Samy109/Ender-3-3DTruder/CAD/3DTruder_schematic.pdf

# System overview

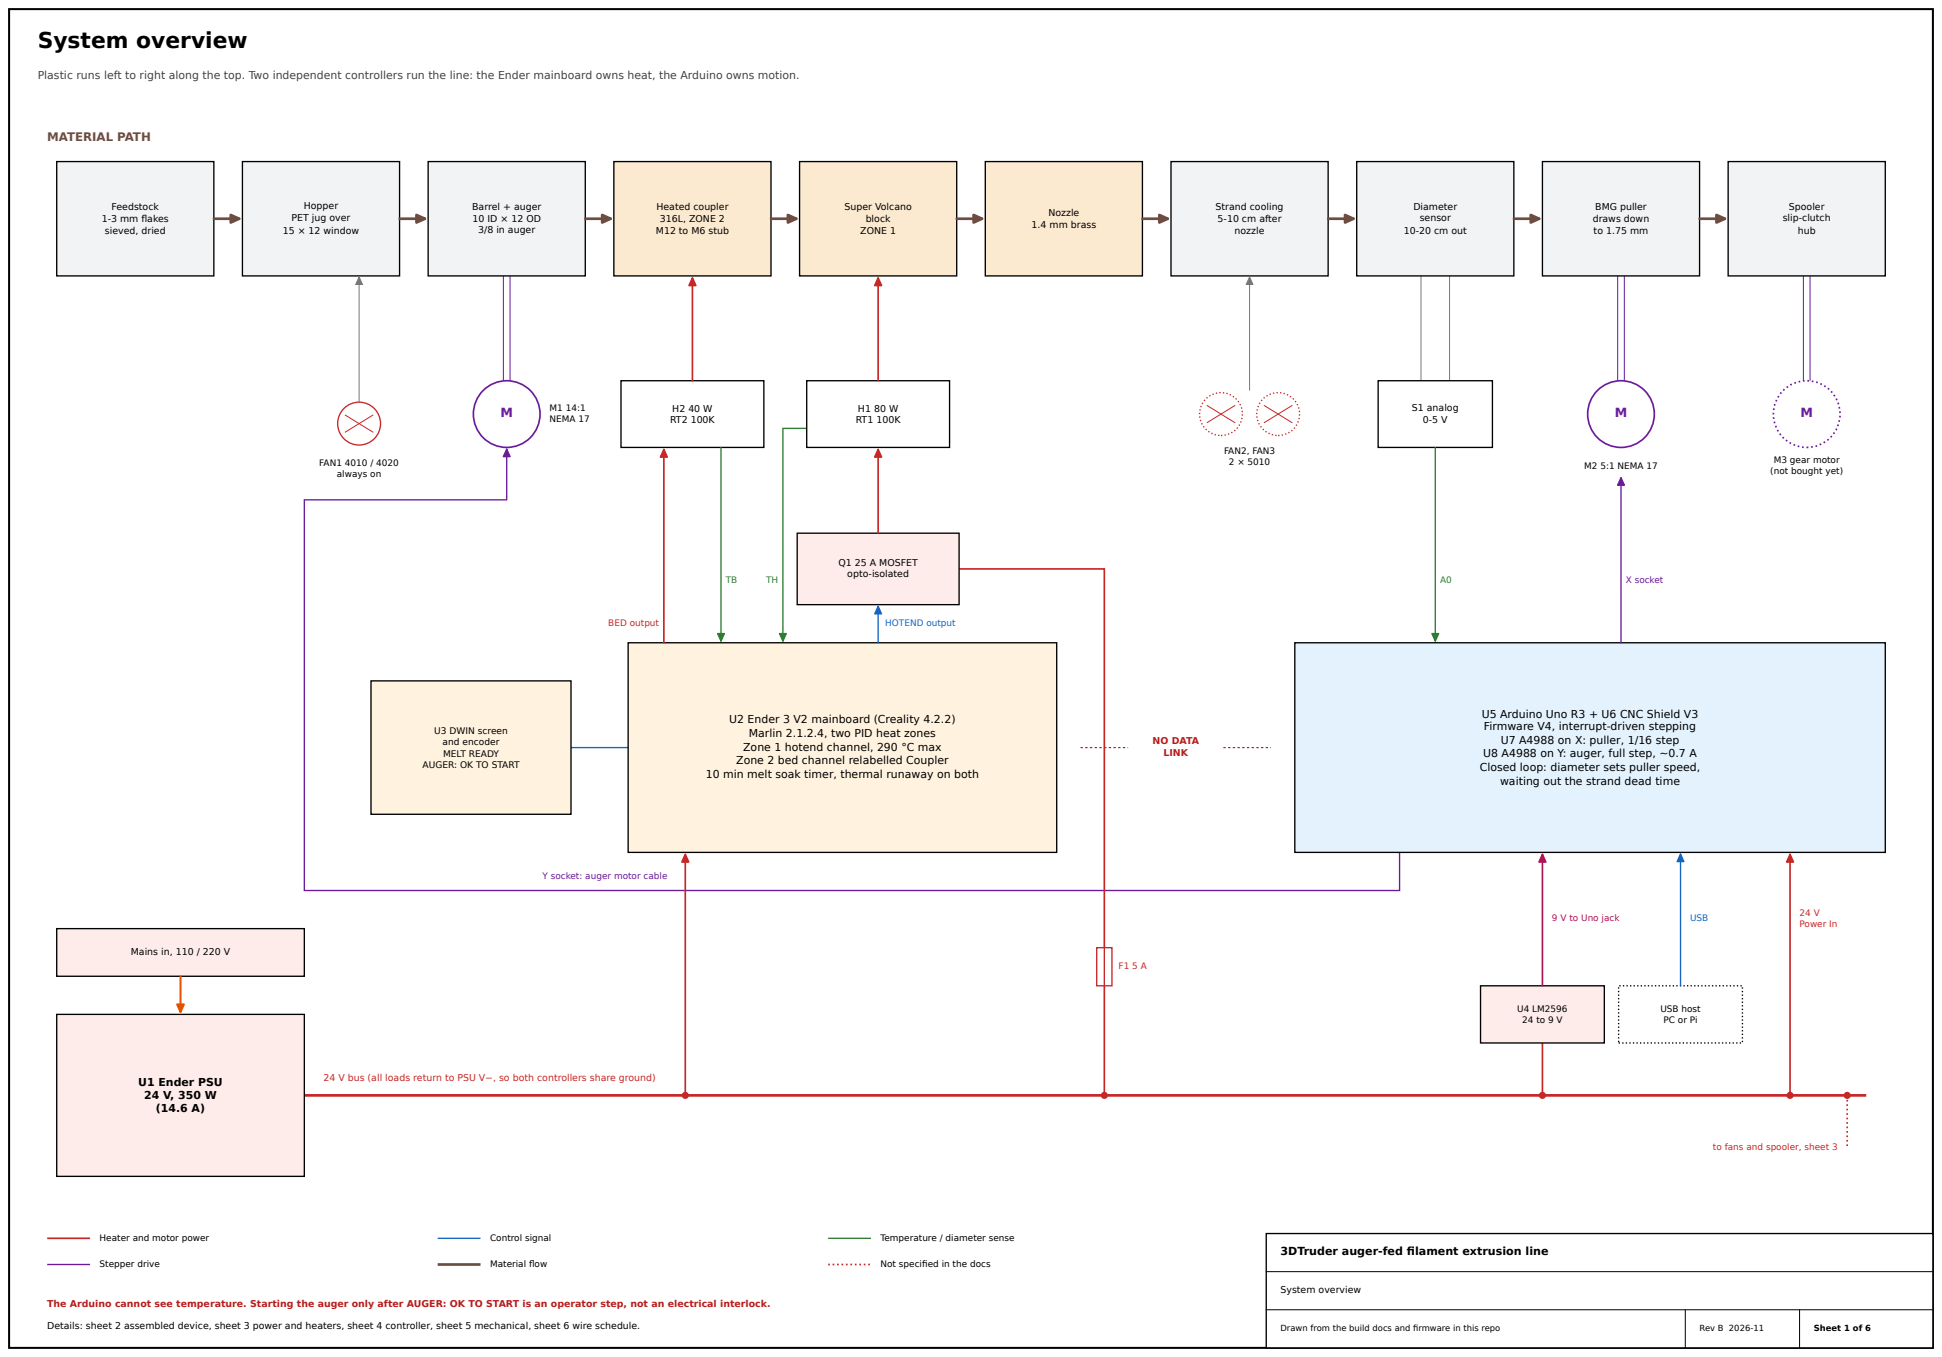
[picture p1: page 1]

Plastic runs left to right along the top. Two independent controllers run the line: the Ender mainboard owns heat, the Arduino owns motion.

U2 Ender 3 V2 mainboard (Creality 4.2.2)
Marlin 2.1.2.4, two PID heat zones
Zone 1 hotend channel, 290 °C max
Zone 2 bed channel relabelled Coupler
10 min melt soak timer, thermal runaway on both

U5 Arduino Uno R3 + U6 CNC Shield V3
Firmware V4, interrupt-driven stepping
U7 A4988 on X: puller, 1/16 step
U8 A4988 on Y: auger, full step, ~0.7 A
Closed loop: diameter sets puller speed,
waiting out the strand dead time

U3 DWIN screen
and encoder
MELT READY
AUGER: OK TO START

Y socket: auger motor cable

24 V bus (all loads return to PSU V−, so both controllers share ground)

to fans and spooler, sheet 3

3DTruder auger-fed filament extrusion line

The Arduino cannot see temperature. Starting the auger only after AUGER: OK TO START is an operator step, not an electrical interlock.

Details: sheet 2 assembled device, sheet 3 power and heaters, sheet 4 controller, sheet 5 mechanical, sheet 6 wire schedule.

# Fully assembled device

Every part in its built position at one common scale (about 1:2.25 at A3), with the electronics and cable runs. Heights and lengths of bought parts are typical values.

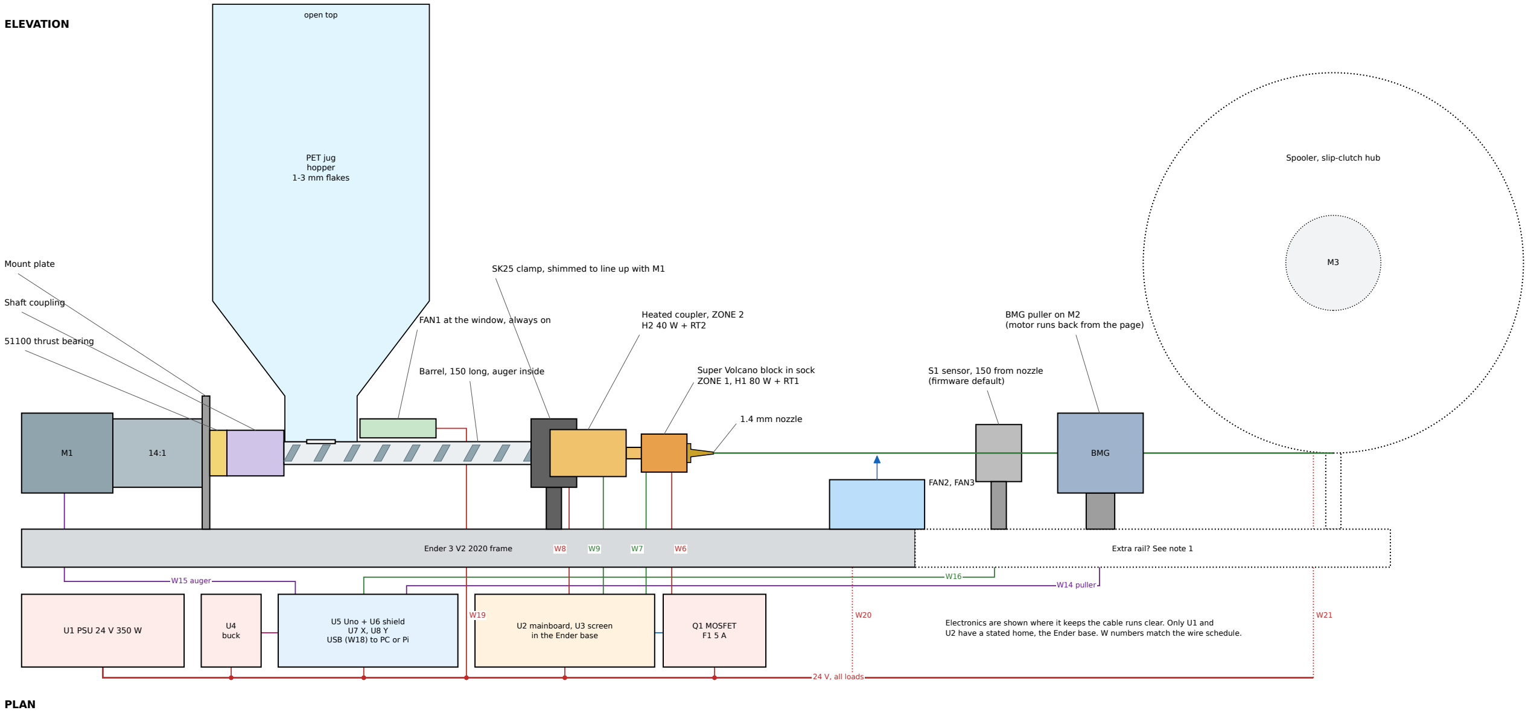
[picture p2: figure]
ELEVATION; PLAN; Ender 3 V2 2020 frame; Extra rail? See note 1; PET jug hopper 1-3 mm flakes; open top; U1 PSU 24 V 350 W; buck; U5 Uno + U6 shield U7 X, U8 Y USB (W18) to PC or Pi; U2 mainboard, U3 screen in the Ender base; Q1 MOSFET F1 5 A; Spooler, slip-clutch hub; BMG; 24 V, all loads; W15 auger; W14 puller; Mount plate; Shaft coupling; 51100 thrust bearing; FAN1 at the window, always on; Barrel, 150 long, auger inside; SK25 clamp, shimmed to line up with M1; Heated coupler, ZONE 2 H2 40 W + RT2; Super Volcano block in sock ZONE 1, H1 80 W + RT1; 1.4 mm nozzle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

Electronics are shown where it keeps the cable runs clear. Only U1 and
U2 have a stated home, the Ender base. W numbers match the wire schedule.

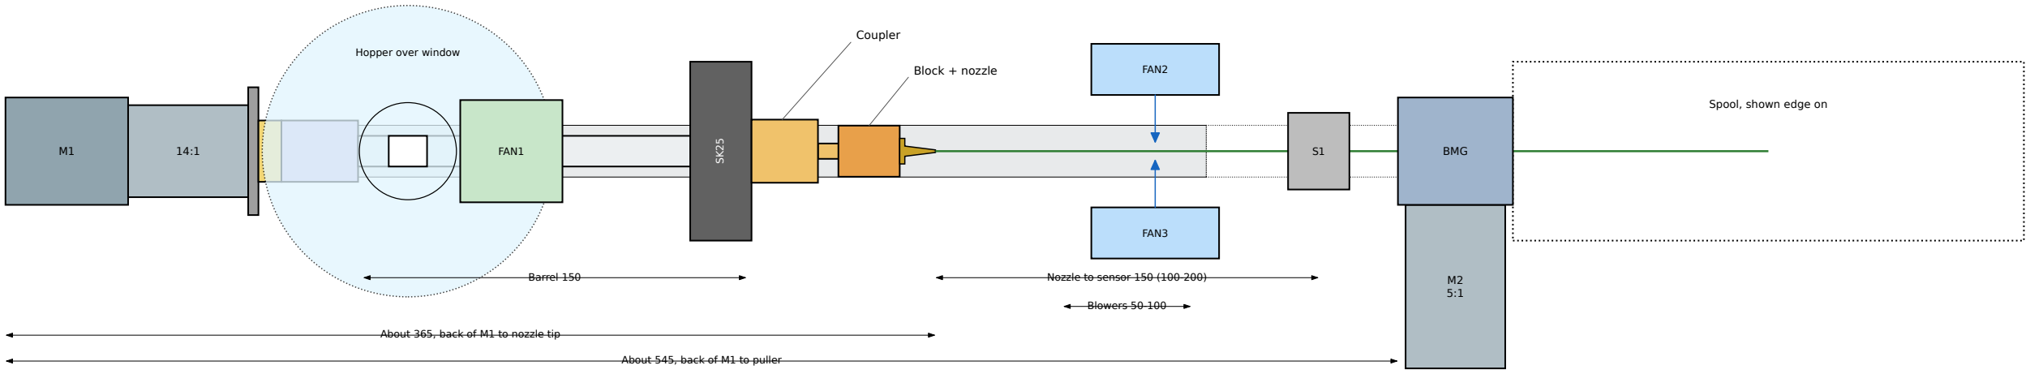
[picture p3: figure]
FAN2; FAN3; FAN1; Hopper over window; Spool, shown edge on; BMG; Barrel 150; Nozzle to sensor 150 (100-200); Blowers 50-100; About 365, back of M1 to nozzle tip; About 545, back of M1 to puller; Coupler; Block + nozzle

1. The docs say the line bolts to the 2020 frame but not to which rail. Back of M1 to puller is about 545 mm and the Ender's footprint is roughly 470 mm, so check the fit. The puller and spooler may need an extra rail or their own stand. Dotted frame is that open question.
2. M1, M2, FAN, BMG, SK25 and spool sizes are typical, not from the repo. Coupler, barrel, thrust bearing and spacings are from the docs. Ender gantry, motors and belts are not drawn.

3DTruder auger-fed filament extrusion line

Fully assembled device

Drawn from the build docs and firmware in this repo | Rev B 2026-11 | Sheet 2 of 6

# Power distribution and heaters

Ladder layout: the 24 V bus runs along the top, the 0 V bus along the bottom, and every load is a rung between them.

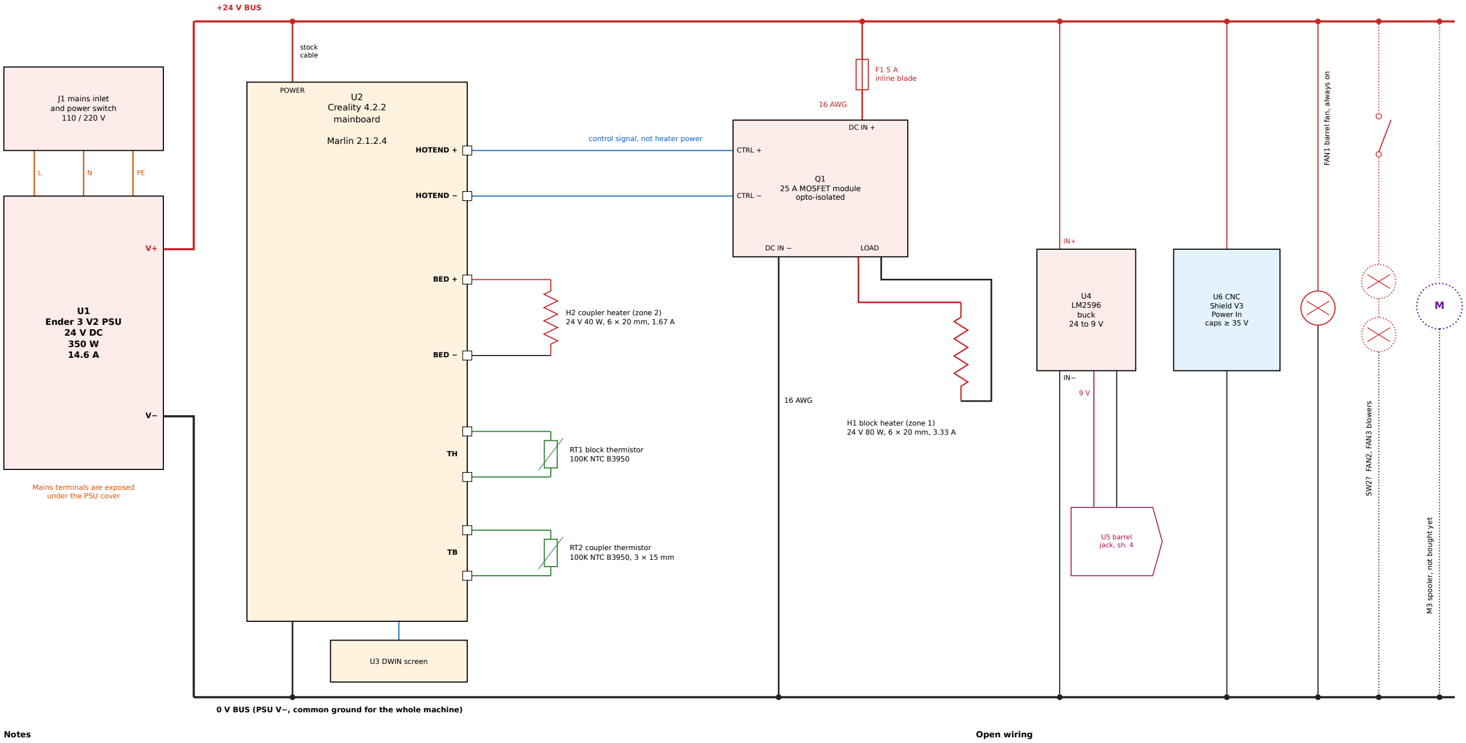
[picture p4: figure]
H2 coupler heater (zone 2) 24 V 40 W, 6 × 20 mm, 1.67 A; RT1 block thermistor 100K NTC B3950; RT2 coupler thermistor 100K NTC B3950, 3 × 15 mm; H1 block heater (zone 1) 24 V 80 W, 6 × 20 mm, 3.33 A; FAN1 barrel fan, always on; SW2? FAN2, FAN3 blowers; M3 spooler, not bought yet; Notes; Open wiring; J1 mains inlet and power switch 110 / 220 V; U1 Ender 3 V2 PSU 24 V DC 350 W 14.6 A; U2 Creality 4.2.2 mainboard; Marlin 2.1.2.4; U3 DWIN screen; Q1 25 A MOSFET module opto-isolated; U4 LM2596 buck 24 to 9 V; U5 barrel jack, sh. 4; U6 CNC Shield V3 Power In caps ≥ 35 V; POWER; HOTEND +; HOTEND −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

1. Unplug from the wall before touching PSU or mainboard wiring.
2. H1 must go through Q1. Its 3.33 A is more than the mainboard MOSFET should carry continuously. H2's 1.67 A is within the bed MOSFET's rating.
3. Connect both thermistors before heating. An unplugged one halts that zone with MINTEMP (5 °C). Limits: nozzle MAXTEMP 305 °C (290 °C settable), coupler 290 °C (280 °C settable).
1. Dotted rungs: the docs do not say how FAN2, FAN3 or M3 are powered. The bus feed and SW2 are the obvious way to do it, not a documented design. A 12 V spooler needs its own buck.
Mains | +24 V | 0 V | Control signal
Thermistor | 9 V | Not specified in the docs

3DTruder auger-fed filament extrusion line

Power distribution and heaters

Drawn from the build docs and firmware in this repo | Rev B 2026-11 | Sheet 3 of 6

### 0 V BUS (PSU V−, common ground for the whole machine)

# Motion controller: Arduino Uno and CNC Shield V3

U6 plugs straight onto U5, so the links between them are header pins, not loose wires. Only the connections at the far left and right are wired by hand.

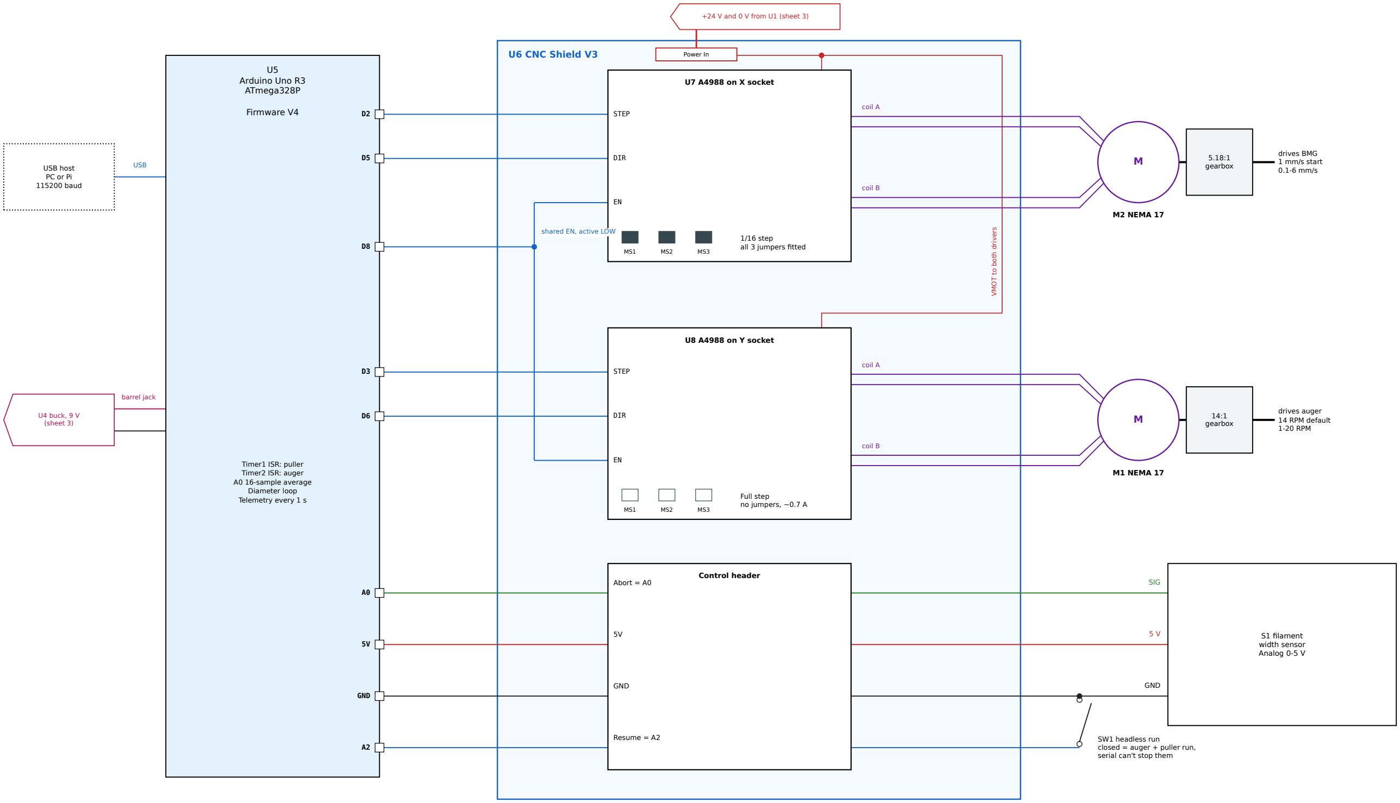
[picture p5: figure]
USB; barrel jack; M2 NEMA 17; drives BMG 1 mm/s start 0.1-6 mm/s; M1 NEMA 17; drives auger 14 RPM default 1-20 RPM; SW1 headless run closed = auger + puller run, serial can't stop them; U5 Arduino Uno R3 ATmega328P; Firmware V4; U6 CNC Shield V3; USB host PC or Pi 115200 baud; U4 buck, 9 V (sheet 3); +24 V and 0 V from U1 (sheet 3); M 5.18:1 gearbox; M 14:1 gearbox; S1 filament width sensor Analog 0-5 V; Timer1 ISR: puller Timer2 ISR: auger A0 16-sample average Diameter loop Telemetry every 1 s; GND; U8 A4988 on Y socket; STEP; DIR; Full step no jumpers, ~0.7 A; Power In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

1. Check the shield's capacitors before applying 24 V: 35 V or 50 V only. Budget shields often ship with 16 V or 25 V parts. Otherwise replace them or run the shield from 12 V.
2. Set U4's output to 9 V with a multimeter before connecting it to the Uno. These modules are adjustable and can arrive set well above 9 V.
3. Auger current is the torque limit: a jam must make M1 skip, not build pressure against the thin barrel thread. Don't raise it to push through a jam.
Step / dir / enable | Stepper coils | Sensor signal | Supply
U7 A4988 on X socket STEP DIR EN | 1/16 step all 3 jumpers fitted

3DTruder auger-fed filament extrusion line

Motion controller: Arduino Uno and CNC Shield V3

Drawn from the build docs and firmware in this repo | Rev B 2026-11 | Sheet 4 of 6

# Mechanical layout and melt path

View A is a side view of the whole line, not to scale. View B is a section through the melt path at 2.5:1, with coupler and barrel to scale.

VIEW A Full line, side view (not to scale)

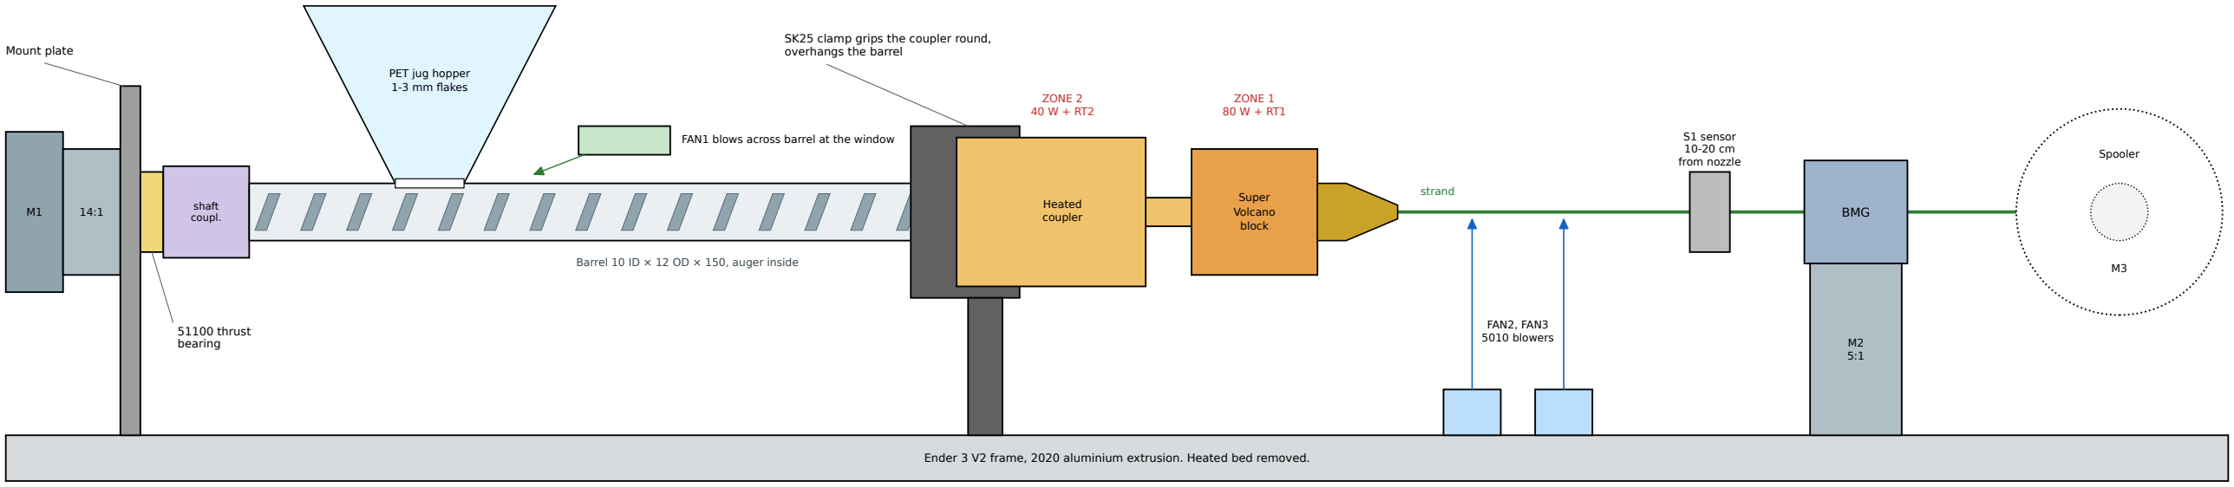
[picture p6: figure]
10-20 cm from nozzle; shaft; coupl.; PET jug hopper 1-3 mm flakes; BMG; Heated coupler; Super Volcano block; Spooler; ZONE 2 40 W + RT2; ZONE 1 80 W + RT1; strand; FAN2, FAN3 5010 blowers; Mount plate; 51100 thrust bearing; SK25 clamp grips the coupler round, overhangs the barrel

Barrel 10 ID × 12 OD × 150, auger inside

FAN1 blows across barrel at the window | S1 sensor

Load paths: melt pressure on the auger goes coupling → 51100 → plate → frame, not through the gearbox. Pressure on the coupler goes SK25 → frame, not through the thin barrel thread.

VIEW B Melt path section, 2.5:1

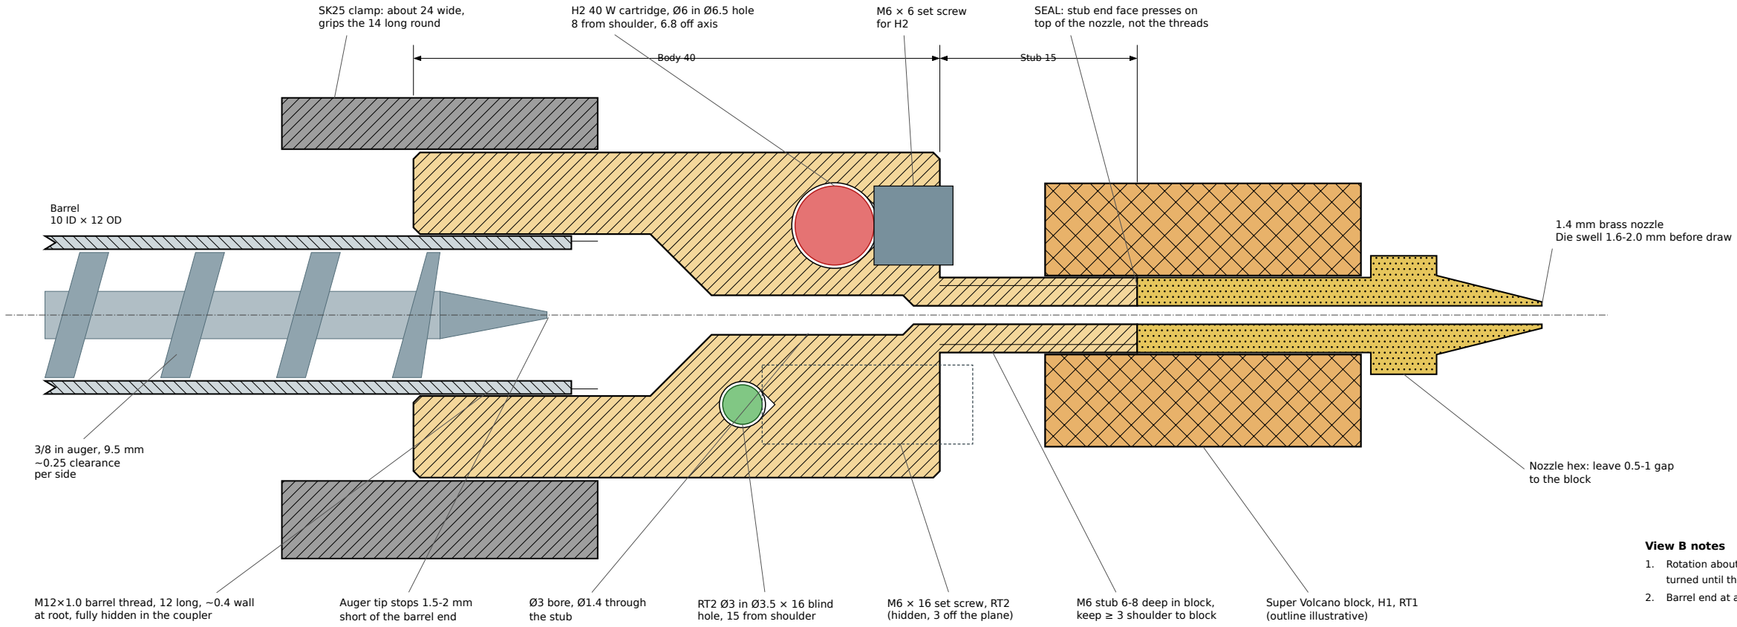
[picture p7: figure]
Barrel 10 ID × 12 OD; View B notes; Body 40; Stub 15; SK25 clamp: about 24 wide, grips the 14 long round; H2 40 W cartridge, Ø6 in Ø6.5 hole 8 from shoulder, 6.8 off axis; M6 × 6 set screw for H2; SEAL: stub end face presses on top of the nozzle, not the threads; 3/8 in auger, 9.5 mm ~0.25 clearance per side; at root, fully hidden in the coupler; Auger tip stops 1.5-2 mm short of the barrel end; Ø3 bore, Ø1.4 through the stub; RT2 Ø3 in Ø3.5 × 16 blind hole, 15 from shoulder; M6 × 16 set screw, RT2 (hidden, 3 off the plane); M6 stub 6-8 deep in block, keep ≥ 3 shoulder to block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

1. Rotation about the axis is set by the barrel thread, then the whole assembly is turned until the hopper window faces up. Drawn with H2 on top for clarity.
2. Barrel end at about z 28, assuming the 12 mm thread is fully run in.

Ender 3 V2 frame, 2020 aluminium extrusion. Heated bed removed.

3DTruder auger-fed filament extrusion line

Mechanical layout and melt path

Drawn from the build docs and firmware in this repo | Rev B 2026-11 | Sheet 5 of 6

M12×1.0 barrel thread, 12 long, ~0.4 wall

# Wire schedule and settings

Every connection and every value you need at the bench. Source for each is the manual, the sketch or Configuration.h.

Wire schedule

Wire | From | To | Carries | Cable / note
W1 | J1 mains inlet | U1 PSU L, N, PE | 110 / 220 V AC | Stock. Unplug before touching
W2 | U1 V+, V− | U2 POWER | 24 V | Stock cable
W3 | U1 V+ | F1, then Q1 DC IN + | 24 V, 3.33 A | 16 AWG red, 5 A fuse on +
W4 | U1 V− | Q1 DC IN − | 0 V | 16 AWG black
W5 | U2 HOTEND +, − | Q1 CONTROL +, − | PWM control | Signal cable, mind polarity
W6 | Q1 LOAD | H1 80 W block heater | 24 V, 3.33 A | Heater leads
W7 | RT1 block thermistor | U2 TH | Temp sense | Marlin sensor type 1
W8 | H2 40 W coupler heater | U2 BED screw terminals | 24 V, 1.67 A | Route away from nozzle
W9 | RT2 coupler thermistor | U2 TB | Temp sense | Marlin sensor type 1
W10 | U2 | U3 DWIN screen | Serial UI | Stock cable
W11 | U1 V+, V− | U6 Power In | 24 V motor power | Check caps first
W12 | U1 V+, V− | U4 IN | 24 V
W13 | U4 OUT | U5 barrel jack | 9 V | Set 9 V before connecting
W14 | U6 X motor header | M2 puller, 5:1 | Stepper coils | Swap a coil pair to reverse
W15 | U6 Y motor header | M1 auger, 14:1 | Stepper coils | Swap a coil pair to reverse
W16 | U6 Abort (A0), 5V, GND | S1 SIG, VCC, GND | 0-5 V analog | Not a digital runout switch
W17 | U6 Resume (A2), GND | SW1 run switch | Closed = run | Optional, headless only
W18 | U5 USB | PC or Pi | 115200 baud | Commands and telemetry
W19 | U1 V+, V− | FAN1 4010 / 4020 | 24 V | Always on, no switch
W20 | Not specified | FAN2, FAN3 5010 | 24 V assumed | OPEN: docs give no supply or switch
W21 | Not specified | M3 spooler | 24 V or 12 V | OPEN: not bought. 12 V needs a buck

Drivers

Stepper driver | Socket / jumpers | Step mode | Current
U7 puller (M2) | X, 3 jumpers fitted | 1/16 | Motor's comfortable running current
U8 auger (M1) | Y, no jumpers | Full, 2800 steps/rev | ~0.7 A, torque limit

Vref = 8 × Rs × I. At 0.7 A: R100 sense resistor 0.56 V, R050 sense resistor 0.28 V.

Presets

Preset | Nozzle | Coupler
PLA | 215 °C | 205 °C
PETG | 240 °C | 230 °C
PET #1 | 270 °C | 260 °C

Arduino pin map

Arduino pin | Shield label | Function
D2 (PD2) / D5 | X STEP / DIR | Puller, Timer1 ISR
D3 (PD3) / D6 | Y STEP / DIR | Auger, Timer2 ISR
D8 | EN | Active LOW, both drivers
A0 | Abort | Diameter sensor
A2 | Resume | Run switch to GND, pull-up

Thermal protection

Marlin setting | Value
Soak timer | 10 min, within 3 °C, resets past 5 °C
MINTEMP both zones | 5 °C
MAXTEMP nozzle / coupler | 305 / 290 °C
Settable max | 290 / 280 °C
Thermal runaway | 60 s, 4 °C, both zones

Calibration

Controller value | Default | Set at commissioning
PULL_STEPS_PER_MM | 2150 | 2150 × 60 / L
SENSOR_DISTANCE_MM | 150 | Measure nozzle to sensor
CAL_ADC_A at 1.50 mm | 300 | Read RAW with gauge pin
CAL_ADC_B at 2.00 mm | 700 | Read RAW with gauge pin
TARGET_DIA / dead band | 1.75 / ±0.02 | Fixed
Correction | Gain 0.5 | Capped ±10 %, min 2 s apart

Serial, 115200 baud, Newline

Serial command | Action
START / STOP, OFF | Auger + puller on / off
PULL ON / OFF | Puller only, for threading
AUG ON / OFF | Auger only, 1.5 s soft start
SPEED <x> | Puller, 0.1-6 mm/s
RPM <x> | Auger, 1-20 RPM
AUTO ON / OFF | Diameter regulation on / frozen
HELP | List commands

Open items at Rev B

1. FAN2, FAN3 supply and switching (W20). The procedure says "Blowers on" but gives no wiring, and the screen menu has no fan item.
2. M3 spooler (W21) is still to buy, so its voltage is not settled.
3. F1 protects only the heater branch. U4, U6, FAN1 and the blower and spooler rungs have no fuse of their own in the docs.
4. The barrel's M12×1.0 thread is listed as still to do in the parts list.

Reference designators

1. U1 PSU, U2 mainboard, U3 screen, U4 buck, U5 Uno, U6 shield, U7 U8 A4988, Q1 MOSFET, F1 fuse, H1 H2 heaters, RT1 RT2 thermistors, M1 auger, M2 puller, M3 spooler, FAN1 barrel fan, FAN2 FAN3 blowers, S1 diameter sensor, SW1 run switch, SW2 blower switch (assumed), J1 mains inlet.

Power and unused hardware

1. Known heater load is 120 W, or 5.0 A of the PSU's 14.6 A. Motors and fans aren't rated in the docs, but that leaves plenty of margin.
2. Ender X, Y, Z and E motor outputs and endstops are not used by this build.

Bring-up order

1. Before any power: check the shield's capacitors are 35 V or 50 V, and set U4 to 9 V on a multimeter with the Uno disconnected.
2. Flash Marlin to U2 and the sketch to U5. Set Vref on U7 and U8 and fit the jumpers.
3. First boot, cold, both thermistors plugged in: the nozzle and COUPLER readouts should both show 20-25 °C.
4. Heat to 250 °C, hold the coupler flats with a 22 mm wrench and tighten the nozzle a further 1/8 turn against the stub.
5. PID tune both zones and save: M303 E0 S220 C8 U1, then M303 E-1 S205 C8 U1, then M500.
6. Heaters off, barrel empty: check both motor directions, calibrate S1 with gauge pins, then puller steps/mm and sensor distance. Re-upload the sketch.
7. Watch one full soak on a preset, through SOAKING: 10:00 to AUGER: OK TO START, before the first run.

3DTruder auger-fed filament extrusion line

Wire schedule and settings

Drawn from the build docs and firmware in this repo | Rev B 2026-11 | Sheet 6 of 6
