Samy109/Ender-3-3DTruder/CAD/shop_order.md

# Print Order: Heated Barrel Coupler

| | |
|---|---|
| **Customer** | Adam Humphries |
| **Part** | Heated barrel coupler, qty 1 |
| **Print file** | `barrel_coupler.step` (all threads modelled and printed) |
| **Drawing** | `barrel_coupler_drawing.pdf` (BC-001 Rev E, generated by `make_drawing.py`) |
| **Process / material** | Metal 3D printing (SLM), 316L stainless steel. Aluminum not acceptable (service temperature 280 °C) |
| **Units** | mm |
| **Tolerance** | ±0.3 on sizes, ±0.5 on holes (standard SLM). No tighter tolerance anywhere, no machining |
| **Finish** | Stress relieved, supports removed, bead blasted |

---

| Feature | As modelled |
|---|---|
| Body | 40 long excluding stub: heater block 21.7 × 24.7 (z 0–26), then Ø24.7 round (z 26–40) |
| Top bore | M12×1.0 internal thread, printed, 14 full thread; hole 18 deep with a 90° cone floor; 0.5 × 45° chamfer |
| Stub | M6×1.0 external thread, printed, full length (15), runs out at the shoulder |
| Through bore | Ø1.4 through the stub and 2 into the body, then a 90° cone up to Ø3.0 through the rest of the body |
| Wrench flats | 21.7 A/F: the two faces of the heater block that the cross holes exit through, 0–26 from the shoulder; 45° corner chamfers into the round |
| Heater hole | Ø6.5 through, perpendicular to the axis and to the flats (exits through both), 6.8 off-center, 8 from the shoulder; 45° teardrop roof |
| Thermistor hole | Ø3.5 × 16 deep from one flat, parallel to the heater hole, 6.8 off-center on the opposite side, 15 from the shoulder; 45° teardrop roof |
| Set screws | M6×1.0 internal threads, printed, from the shoulder face into the heater and thermistor holes |

**Notes**
1. Print axis vertical, top (M12) face on the plate, stub up. The teardrop roofs, the cone floor and the 45° block corners are there so no supports are needed.
2. Every fit already allows for the tolerance. The threads are offset in the model: the M6 stub is 0.3 under size and the M12 and M6 set-screw threads are 0.3 over (a tight internal thread will be chased with a tap). The holes the cartridges slide into are 0.5 over, and the flats and the clamp round are 0.3 under. Print the model as it is; don't correct these sizes back to nominal.
3. Keep the bore, threads and cross holes clear of powder.
4. Minimum wall is 2.0 mm except the M6 stub (1.5 mm under the thread root, the most an M6 allows) and the thread teeth themselves. All threads are M6 or larger and are modelled in the file; no tapping or other machining is needed from you.

**Customer checks on arrival**
- [ ] The M6 stub screws into the Super Volcano block by hand
- [ ] The barrel's M12×1.0 thread screws into the top by hand
- [ ] A 6 mm cartridge slides into the heater hole and a 3 mm thermistor into its hole
- [ ] M6 set screws run in by hand or with a hex key (chase with an M6×1.0 tap if tight; same for the M12 with the M12×1.0 tap)
- [ ] A 22 mm wrench fits the flats
- [ ] Clear sight line through the bore (if the Ø1.4 printed small or holds powder, run a 1.4 mm drill through by hand)
