Samy109/Ender-3-3DTruder/CAD/barrel_coupler.step

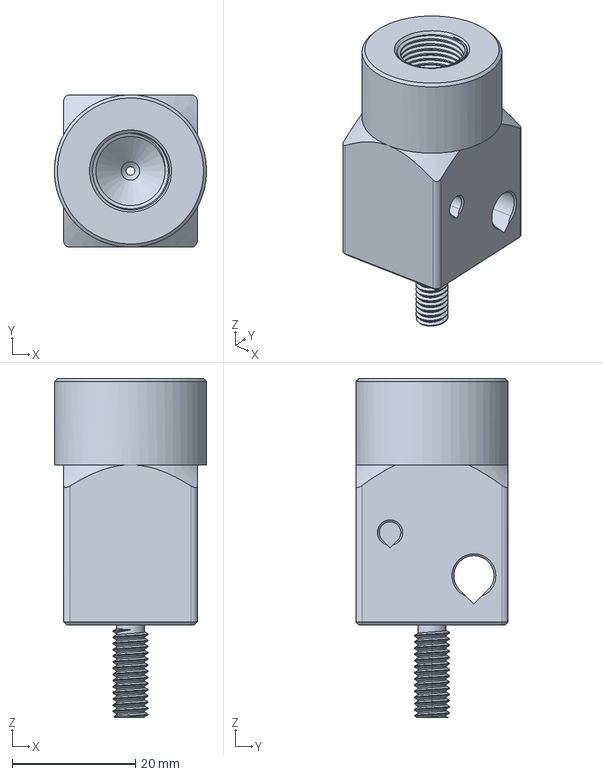
[picture p8: CAD file, 2026-10-26]
CAD/barrel_coupler.step
24.7 x 24.7 x 55.0 mm
