Samy109/Ender-3-3DTruder/(list of files, cad)

Other CAD files:
CAD/barrel_coupler.stl
