Samy109/Ender-3-3DTruder/Ender_3_3DTruder_Master_Manual.html

Build & Operating Manual

3DTRUDER MASTER MANUAL

Auger-Fed Super Volcano Extrusion Line

Turns an Ender 3 V2 into a closed-loop recycling line that extrudes shredded plastic into 1.75 mm filament.

Melt Path

316L Coupler → Super Volcano

Two heat zones: 80 W block + 40 W heated coupler, no heatbreak

Nozzle

1.4 mm Brass Super Volcano

Die swell drawn down to 1.75 mm by the puller

Auger Drive

14:1 NEMA 17 + 51100 Bearing

3/8" auger in a 10 × 12 mm stainless barrel, ~0.7 A torque limit

Control

Arduino V4 + Marlin Soak Timer

Interrupt-driven motors, dead-time-aware diameter loop

Revision: 4.0 (October 2026)

Platform: Ender 3 V2 Conversion

Output: 1.75 mm Recycled Filament

3DTruder Master Manual1. Overview & Safety

# 📌 1. Overview & Safety

## How it works

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

## Safety Warnings

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

## Design notes

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

3DTruder Master Manual2. Bill of Materials

# 🛒 2. Bill of Materials

Full list with specs and links: amazon_parts_list.md. Shop-made parts: CAD/shop_order.md.

## 🔹 Base Unit

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

## 🔹 Melt Zone

- Super Volcano heater block + 1.4 mm Super Volcano brass nozzle + silicone sock
- 80 W 24 V heater cartridge + 100K NTC B3950 thermistor cartridge
- 25 A external MOSFET module + 16 AWG silicone wire + 5 A inline fuse
- Heated barrel coupler (316L stainless, metal 3D printed at ±0.3 mm on sizes and ±0.5 mm on holes, threads printed): 40 mm long: a 21.7 × 24.7 mm heater block (its 21.7 mm faces are the wrench flats) under a Ø24.7 mm round for the clamp. M12×1.0 female top, M6×1.0 male stub (15 mm, full thread), Ø1.4 mm bore through the stub and 2 mm into the body, opening to Ø3 mm above that, flats for a 22 mm wrench, cross holes for a 6 mm heater cartridge and a 3 mm thermistor, M6 set screws. No machining expected; the taps and drill under Tools are only for cleanup if something prints tight. See CAD/shop_order.md and CAD/barrel_coupler.step.
- SK25 shaft support: clamps the coupler's round top section to the frame.
- M6 stainless set screws: one 6 mm (heater) and one 16 mm (thermistor), plus a 3 mm hex key.
- Coupler heat zone: 24 V 40 W 6 × 20 mm cartridge heater + 100K B3950 thermistor cartridge (3 × 15 mm), wired to the mainboard's bed terminals and TB thermistor header.
- PTFE thread tape for the barrel thread.

## 🔹 Auger Feed

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

## 🔹 Hopper & Feedstock

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

## 🔹 Puller & Control

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

## 🔹 Tools

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

3DTruder Master Manual3. Feedstock & Hopper

# 📥 3. Feedstock & Hopper

## 3.1 Sifting (3-Stage Stack)

Stack screens top to bottom: 5 mm → 3 mm → 1 mm → catch pan, and shake well.

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

ⓘ Note

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

## 3.2 Pre-Drying

Moisture boils in the melt zone and causes popping, voids and brittle filament.

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

## 3.3 Bottle Hopper

The barrel is horizontal, so the hopper sits upside-down on top of the window.

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

3DTruder Master Manual4. Phase 1: Auger, Barrel & Melt Zone Assembly

# 🔧 4. Phase 1: Auger, Barrel & Melt Zone Assembly

## 4.1 Modifying the Auger Bit

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

## 4.2 Motor, Thrust Bearing & Shaft Coupling

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

## 4.3 Barrel Prep

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

## 4.4 Melt Zone Assembly

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

## 4.5 Heater Wiring

Zone 1, Super Volcano block (80 W), through the external MOSFET:

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

Zone 2, coupler (40 W), straight to the board:

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

! Warning

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

## 4.6 First Boot, First Heat, Hot-Tighten & PID

1. Flash the Ender 3 V2 firmware (see Ender3_Firmware/README.md): firmware_Ender3_V2_RE.bin or _RC.bin to match the chip on your board. If the board has been flashed before, rename the file to something new so the bootloader picks it up.
2. First boot, cold: both thermistors plugged in (nozzle on TH, coupler on TB). The nozzle readout and the COUPLER: line should both show room temperature (about 20–25 °C). A reading near or below 0 °C, or an error, means a thermistor isn't connected.
3. Set the hotend to 250 °C and wait a few minutes.
4. Hold the coupler's flats with a 22 mm wrench (on the upper part of the flats, clear of the heater and thermistor leads) and tighten the nozzle a further ⅛ turn against the stub.
5. Run PID autotune on both zones and save, either from the screen (Configuration → Advanced Settings → PID Autotune for the nozzle and the Coupler, then Store Settings) or over USB:

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

The coupler ships with rough starting PID values, so tune it before the first real run.

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

3DTruder Master Manual5. Phase 2: Puller, Sensor & Controller

# 🎛️ 5. Phase 2: Puller, Sensor & Controller

## 5.1 Strand Line Layout

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

## 5.2 CNC Shield V3 Wiring

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

× Caution

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

## 5.3 Driver Current (Vref)

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

## 5.4 Controller Firmware

Flash Arduino_Firmware.ino to the Uno from the Arduino IDE (Tools → Board → Arduino Uno, pick the port, Upload), or with arduino-cli (use your own COM port):

arduino-cli compile -b arduino:avr:uno -u -p COM7 Arduino_Firmware

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

## 5.5 Commissioning & Calibration

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

! Warning

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

3DTruder Master Manual6. Operating Procedure

# 🚀 6. Operating Procedure

## 6.1 Startup

Screen presets (each sets both heat zones):

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

## 6.2 Shutdown

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

## 6.3 Troubleshooting

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
