Samy109/Ender-3-3DTruder/CAD/assembly_overview.pdf

# 3DTruder: AUGER-FED FILAMENT EXTRUSION LINE, ASSEMBLED SIDE VIEW

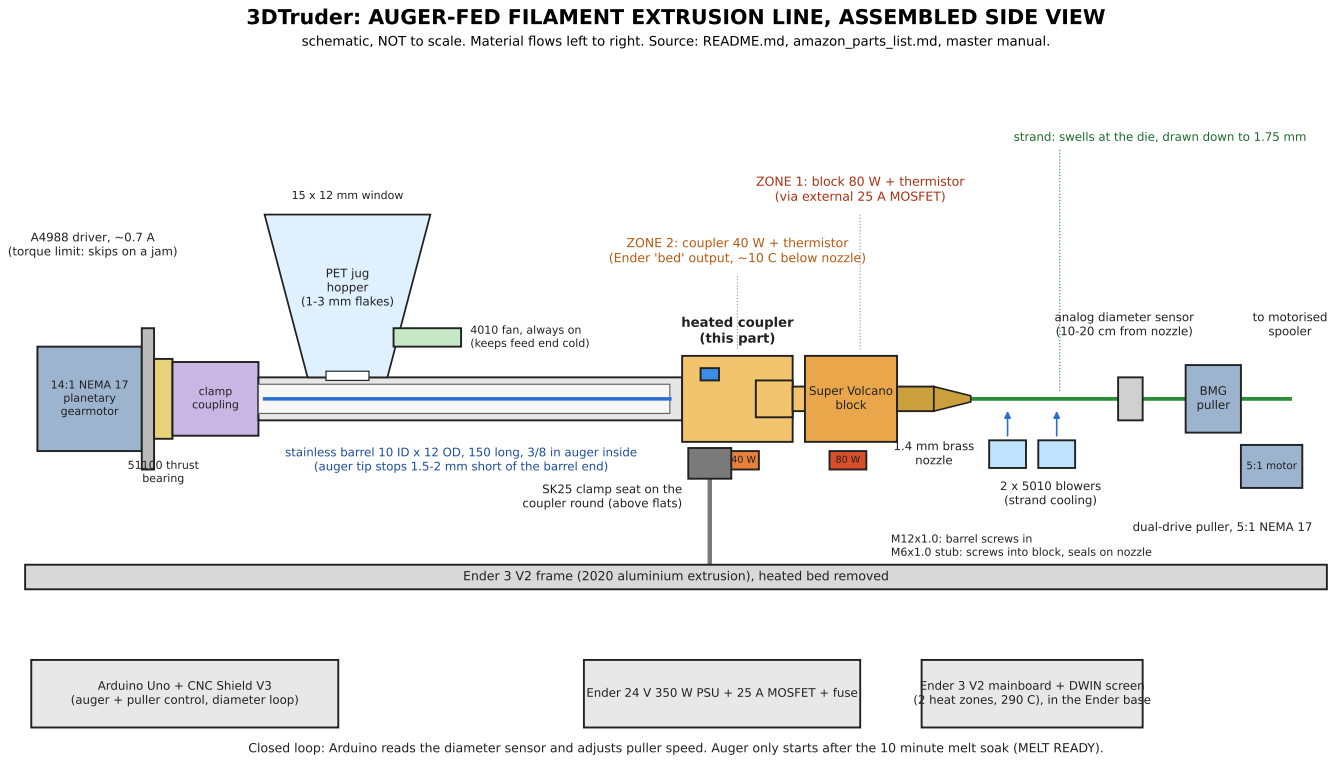
[picture p9: page 1]
14:1 NEMA 17 planetary gearmotor; clamp coupling; 51100 thrust bearing; PET jug hopper (1-3 mm flakes); 15 x 12 mm window; heated coupler; (this; part); Super Volcano block; 1.4 mm brass nozzle; 2 x 5010 blowers (strand cooling); BMG puller; 5:1 motor; to motorised spooler; (auger + puller control, diameter loop); Ender 24 V 350 W PSU + 25 A MOSFET + fuse

schematic, NOT to scale. Material flows left to right. Source: README.md, amazon_parts_list.md, master manual.

strand: swells at the die, drawn down to 1.75 mm

ZONE 1: block 80 W + thermistor
(via external 25 A MOSFET)

A4988 driver, ~0.7 A
(torque limit: skips on a jam)

ZONE 2: coupler 40 W + thermistor
(Ender 'bed' output, ~10 C below nozzle)

analog diameter sensor
(10-20 cm from nozzle)

4010 fan, always on
(keeps feed end cold)

stainless barrel 10 ID x 12 OD, 150 long, 3/8 in auger inside
(auger tip stops 1.5-2 mm short of the barrel end)

SK25 clamp seat on the
coupler round (above flats)

dual-drive puller, 5:1 NEMA 17

M12x1.0: barrel screws in
M6x1.0 stub: screws into block, seals on nozzle

Ender 3 V2 frame (2020 aluminium extrusion), heated bed removed

Arduino Uno + CNC Shield V3

Ender 3 V2 mainboard + DWIN screen
(2 heat zones, 290 C), in the Ender base

Closed loop: Arduino reads the diameter sensor and adjusts puller speed. Auger only starts after the 10 minute melt soak (MELT READY).
