Samy109/Ender-3-3DTruder/CAD/barrel_coupler_drawing.pdf

## VIEW B (TOP, FROM +Z)

## NOTES (UNITS: mm)

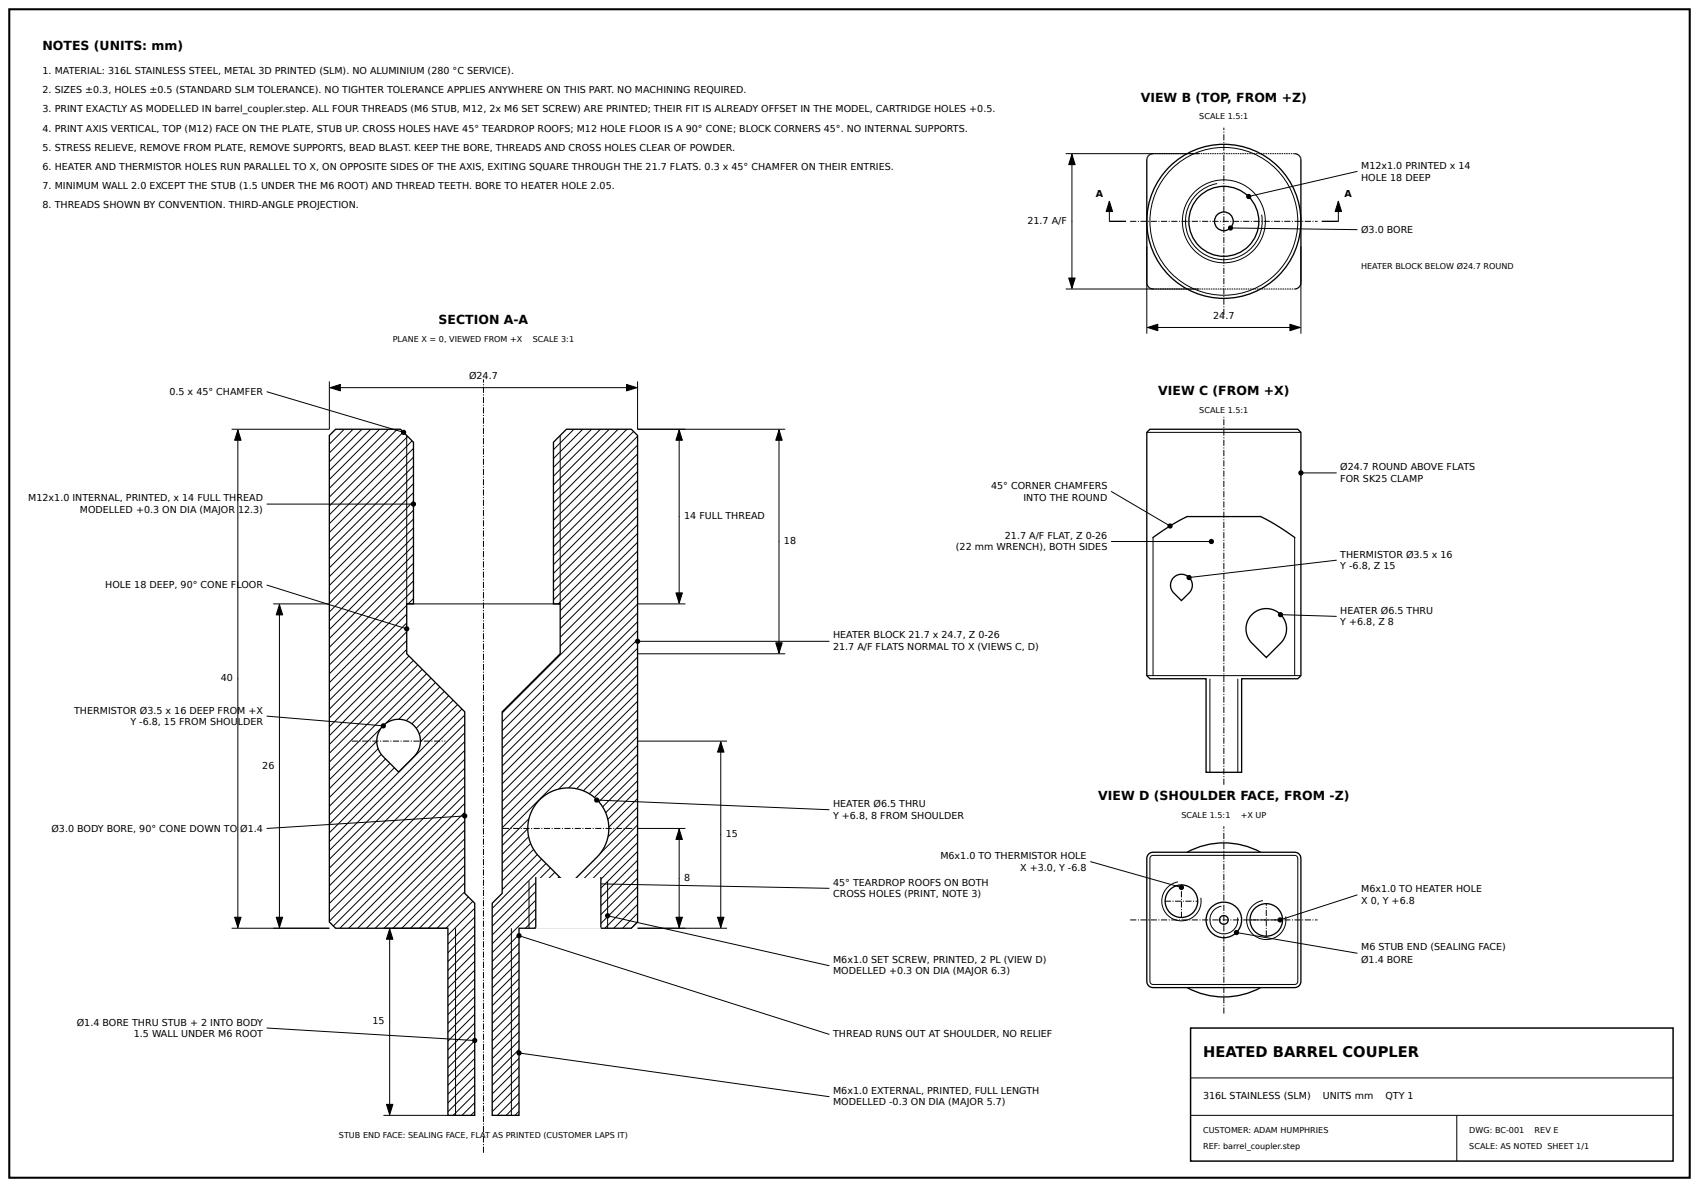
[picture p10: page 1]
SECTION A-A; 14 FULL THREAD; 0.5 x 45° CHAMFER; Y -6.8, 15 FROM SHOULDER; HEATER Ø6.5 THRU Y +6.8, 8 FROM SHOULDER; VIEW C (FROM +X); SCALE 1.5:1; HEATER Ø6.5 THRU Y +6.8, Z 8; THERMISTOR Ø3.5 x 16 Y -6.8, Z 15; 21.7 A/F FLAT, Z 0-26; M12x1.0 PRINTED x 14 HOLE 18 DEEP; Ø3.0 BORE; SCALE 1.5:1 +X UP

1. MATERIAL: 316L STAINLESS STEEL, METAL 3D PRINTED (SLM). NO ALUMINIUM (280 °C SERVICE).
2. SIZES ±0.3, HOLES ±0.5 (STANDARD SLM TOLERANCE). NO TIGHTER TOLERANCE APPLIES ANYWHERE ON THIS PART. NO MACHINING REQUIRED.
3. PRINT EXACTLY AS MODELLED IN barrel_coupler.step. ALL FOUR THREADS (M6 STUB, M12, 2x M6 SET SCREW) ARE PRINTED; THEIR FIT IS ALREADY OFFSET IN THE MODEL, CARTRIDGE HOLES +0.5.
4. PRINT AXIS VERTICAL, TOP (M12) FACE ON THE PLATE, STUB UP. CROSS HOLES HAVE 45° TEARDROP ROOFS; M12 HOLE FLOOR IS A 90° CONE; BLOCK CORNERS 45°. NO INTERNAL SUPPORTS.
5. STRESS RELIEVE, REMOVE FROM PLATE, REMOVE SUPPORTS, BEAD BLAST. KEEP THE BORE, THREADS AND CROSS HOLES CLEAR OF POWDER.
6. HEATER AND THERMISTOR HOLES RUN PARALLEL TO X, ON OPPOSITE SIDES OF THE AXIS, EXITING SQUARE THROUGH THE 21.7 FLATS. 0.3 x 45° CHAMFER ON THEIR ENTRIES.
7. MINIMUM WALL 2.0 EXCEPT THE STUB (1.5 UNDER THE M6 ROOT) AND THREAD TEETH. BORE TO HEATER HOLE 2.05.
8. THREADS SHOWN BY CONVENTION. THIRD-ANGLE PROJECTION.

HEATER BLOCK BELOW Ø24.7 ROUND

PLANE X = 0, VIEWED FROM +X SCALE 3:1

Ø24.7 ROUND ABOVE FLATS
FOR SK25 CLAMP

45° CORNER CHAMFERS
INTO THE ROUND

M12x1.0 INTERNAL, PRINTED, x 14 FULL THREAD

MODELLED +0.3 ON DIA (MAJOR 12.3)

(22 mm WRENCH), BOTH SIDES

HOLE 18 DEEP, 90° CONE FLOOR

HEATER BLOCK 21.7 x 24.7, Z 0-26
21.7 A/F FLATS NORMAL TO X (VIEWS C, D)

THERMISTOR Ø3.5 x 16 DEEP FROM +X

VIEW D (SHOULDER FACE, FROM -Z)

Ø3.0 BODY BORE, 90° CONE DOWN TO Ø1.4

M6x1.0 TO THERMISTOR HOLE

45° TEARDROP ROOFS ON BOTH
CROSS HOLES (PRINT, NOTE 3)

M6x1.0 TO HEATER HOLE

M6 STUB END (SEALING FACE)
Ø1.4 BORE

M6x1.0 SET SCREW, PRINTED, 2 PL (VIEW D)
MODELLED +0.3 ON DIA (MAJOR 6.3)

Ø1.4 BORE THRU STUB + 2 INTO BODY

1.5 WALL UNDER M6 ROOT

THREAD RUNS OUT AT SHOULDER, NO RELIEF

HEATED BARREL COUPLER

M6x1.0 EXTERNAL, PRINTED, FULL LENGTH
MODELLED -0.3 ON DIA (MAJOR 5.7)

316L STAINLESS (SLM) UNITS mm QTY 1

STUB END FACE: SEALING FACE, FLAT AS PRINTED (CUSTOMER LAPS IT)

CUSTOMER: ADAM HUMPHRIES
REF: barrel_coupler.step

DWG: BC-001 REV E
SCALE: AS NOTED SHEET 1/1
