Samy109/Ender-3-3DTruder/(commit log)

2026-10-11 Initial commit: Ender 3 3DTruder complete documentation and firmware
    [Configuration.h, Configuration_adv.h]
2026-10-11 Remove redundant loose capacitors and gear kit; streamline BOM
2026-10-11 feat(firmware): implement clean native DWIN vector UI for Ender 3 V2 screen with custom 3DTruder melt station interface and streamlined controls
    [Configuration.h, Configuration_adv.h]
2026-10-15 Heated barrel coupler, two-zone Marlin, V4 Arduino controller, rebuilt docs
    Melt path
    - Replace the barrel-to-block adapter with a shop-made heated brass coupler:
    M12x1.0 female (barrel), M6x1.0 male stub into the Super Volcano block,
    40 W cartridge + thermistor cross holes. CadQuery source, STEP/STL and a
    machinist shop order live in CAD/.
    Ender 3 V2 firmware (Marlin 2.1.2.4, RE + RC rebuilt)
    - Bed channel now drives the coupler as a second heat zone with PID and
    thermal-runaway protection; menus relabelled "Coupler"; presets set both.
    - HEATER_0_MINTEMP 5 (was 0).
    - Status screen: coupler readout, 10-minute soak across both zones before
    MELT READY / AUGER: OK TO START, fixed lef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
    [Configuration.h, Configuration_adv.h, barrel_coupler.step, barrel_coupler.stl]
2026-10-15 docs(manual): add first-boot and commissioning steps
    - 4.6: flash notes, cold first-boot thermistor check for both zones,
    watch one full soak after PID tuning.
    - 5.4: flashing the Uno (IDE or arduino-cli) and the expected serial output.
    - 5.5: new commissioning section: floating-A0 warning, motor direction
    checks, sensor gauge-pin calibration, puller steps/mm, sensor distance.
    - Re-exported HTML and PDF.
2026-10-15 docs: single-part work order for the heated coupler; tube threading moves to the manual
    - CAD/shop_order.md: rewritten as a one-part machinist work order
    (heated coupler only) with thread classes and tolerances.
    - Manual 4.3: step-by-step M12x1.0 die threading of the barrel tube.
    - Hex shank is centered with a soda-can shim instead of a turned sleeve.
    - Parts list: die handle (38 mm) added; README and HTML/PDF updated.
2026-10-17 Coupler moves to 316L metal print; docs brought in line
    CAD
    - barrel_coupler.py ported to build123d + bd_warehouse with all threads
    modelled (M6, M12, 2x M3); --no-threads writes a plain variant.
    - Print-friendly geometry: Ø2 stub bore, 18 deep M12 hole with a 90°
    cone floor, 45° teardrop roofs on the cross holes.
    - Added the BC-001 drawing, the assembly overview, and the no-thread
    STEP/STL.
    - Shop order rewritten for SLM: print orientation, post-machining of the
    sealing face and threads, M3 printed at Ø2.5 and tapped, and the order
    governs where it differs from the drawing.
    Docs
    - Brass coupler -> 316L everywhere (README, manual, parts list, firmware
    README, Configuration.h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
    [Configuration.h, barrel_coupler.step, barrel_coupler.stl, barrel_coupler_nothreads.step, barrel_coupler_nothreads.stl]
2026-10-17 docs: final alignment pass
    - Manual 6.1/6.2 and Arduino README: the A2 run switch starts both motors
    at the sketch defaults, and serial STOP/OFF can't stop them while it is
    closed. Open the switch to stop.
    - README: drop the Raspberry Pi webcam/plotting claim (nothing in the repo
    does that); describe USB serial hosting and the 1 s telemetry instead.
    - Firmware README: GD32F303RET6 boards take the RE build; RC is for
    STM32F103RCT6.
    - Manual HTML/PDF rebuilt.
2026-10-17 CAD: regenerate drawing BC-001 as Rev B from a script
    - New CAD/make_drawing.py builds barrel_coupler_drawing.pdf with
    matplotlib from the same numbers as barrel_coupler.py, so the drawing
    can be rebuilt whenever the part changes.
    - Notes now match the shop order: M3 printed at Ø2.5 and tapped after
    printing, post-machining of the sealing face and threads, inspection
    list. The old "all threads modelled / print to finished size"
    contradiction is gone.
    - Section A-A drawn true to the model (plane X = 0) with teardrop roofs,
    the 90° cone floor and the heater set screw. Added view D of the
    shoulder face showing both M3 holes. Section arrows on view B now
    point the right way, an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
2026-10-17 Coupler redesigned for PCBWay's ±0.3 mm SLM limit, threads printed
    PCBWay rejected Rev B: their metal printing holds ±0.3 and the drawing
    asked for ±0.1, 0.02 flatness and 0.05 TIR. CNC is too expensive and hand
    thread cutting is out, so the coupler is now printed to size with no
    machining or tapping afterwards.
    - Every fit is offset for ±0.3: M6 stub printed at major 5.7, M12 bore at
    12.3, heater hole Ø6.3, thermistor hole Ø3.3, flats 21.7 A/F (22 mm
    wrench), clamp round Ø24.7 (SK25), relief Ø4.4 under the M6 root.
    - Set screws go from M3 (too fine to print) to printed M5x0.8 at 5.3;
    the thermistor screw moves to X +3 to keep wall to the OD.
    - No-thread variant and its fi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
    [barrel_coupler.step, barrel_coupler.stl, barrel_coupler_nothreads.step, barrel_coupler_nothreads.stl]
2026-10-21 Update cooling fan specs, 2020 mounting instructions, and rebuild manual
2026-10-21 Update barrel fan mounting to direct zip-tie on 4010/4020 fan
2026-10-23 Coupler Rev D: 1.5 mm minimum wall and M6 set screws for PCBWay
    PCBWay flagged walls under 1.5 mm and threads below M6. All threads were
    already modelled in the file; this fixes the rest.
    - Stub bore Ø2.0 -> Ø1.4 (nozzle orifice), giving 1.5 wall under the M6
    root; Ø4.4 relief removed, thread runs out at the shoulder.
    - Heater zone (z 0-26) is now a 21.7 x 24.7 block. Both cross holes exit
    square through its 21.7 faces, which are also the wrench flats, so no
    feather edges where they used to break out of the round. Corners are
    chamfered 45 deg into the Ø24.7 round so it still prints unsupported.
    - Set screws M5x0.8 -> M6x1.0 printed (major 6.3).
    - Only thread teeth remain und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
    [barrel_coupler.step, barrel_coupler.stl]
2026-10-23 docs: align shop order and manual with coupler Rev D
    - Shop order: heater hole exits through both flats, thermistor hole is
    16 deep from one flat, and the 45 deg block corners are listed among
    the no-support features.
    - Manual: note that the stub bore stays 1.4 mm if a 2.0 mm nozzle is
    fitted. Manual HTML/PDF rebuilt.
2026-10-24 docs: coupler is now ordered from JLC3D, not PCBWay
2026-10-26 Coupler Rev E: remove 0.74 mm neck at the shoulder, fits for ±0.5 holes
    JLC3D flagged a thin area at the stub root and quoted ±0.3 on sizes but
    ±0.5 on holes.
    - The Ø3.0 body bore ran down to the shoulder, leaving the stub hanging
    from a 0.74 mm ring (Ø3.0 bore inside the Ø4.47 M6 root). The Ø1.4 stub
    bore now runs 2 mm into the body, then a 90 deg cone opens to Ø3.0.
    - Cartridge holes +0.5 for the hole tolerance: heater Ø6.5, thermistor
    Ø3.5. Both moved to 6.8 off-axis (2.05 wall to the bore, was 1.85);
    heater raised to z 8 for ~3 turns of set-screw thread. Block corners
    R2 -> R1 so the heater exit stays clear of the corner round.
    - Threads stay offset 0.3: a tight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
    [barrel_coupler.step, barrel_coupler.stl]
2026-10-26 CAD: drawing docstrings say R1 block corners
2026-10-26 docs: final fit check of the Rev E coupler against the assembly guide
    Assembly order in manual 4.4 fixed so every step is physically possible:
    - SK25 goes onto the barrel first: the coupler's heater block (corners
    ~Ø31) won't pass its Ø25 bore and the Ø32 shaft coupling blocks the
    other end.
    - Coupler cartridges and set screws go in after the barrel and before
    the block: with the stub in the block the shoulder sits a few mm above
    it and a hex key won't fit; installing them before the barrel would
    wind the leads up on the ~12 turns of thread.
    - Turn the block onto the stub, keep >= 3 mm under the shoulder for the
    set-screw heads (which stand ~1 and ~2 mm proud).
    - Clamp step: s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
    [barrel_coupler.step]
2026-10-26 docs: auger shaft coupling now fits the hex shank directly, no soda-can shim
    Manual BOM, 4.2 steps and troubleshooting, and the parts list updated for the new coupling (8 mm motor shaft to 9 mm hex shank, no shim). The SK25 grip shim is unchanged. Manual HTML/PDF rebuilt.
2026-11-07 docs: six-sheet system schematic (CAD/3DTruder_schematic.pdf, built by make_schematic.py), linked from the README
